Guivve-A/MyosaContest/pneumocoach/enclosure-exploded-half.png

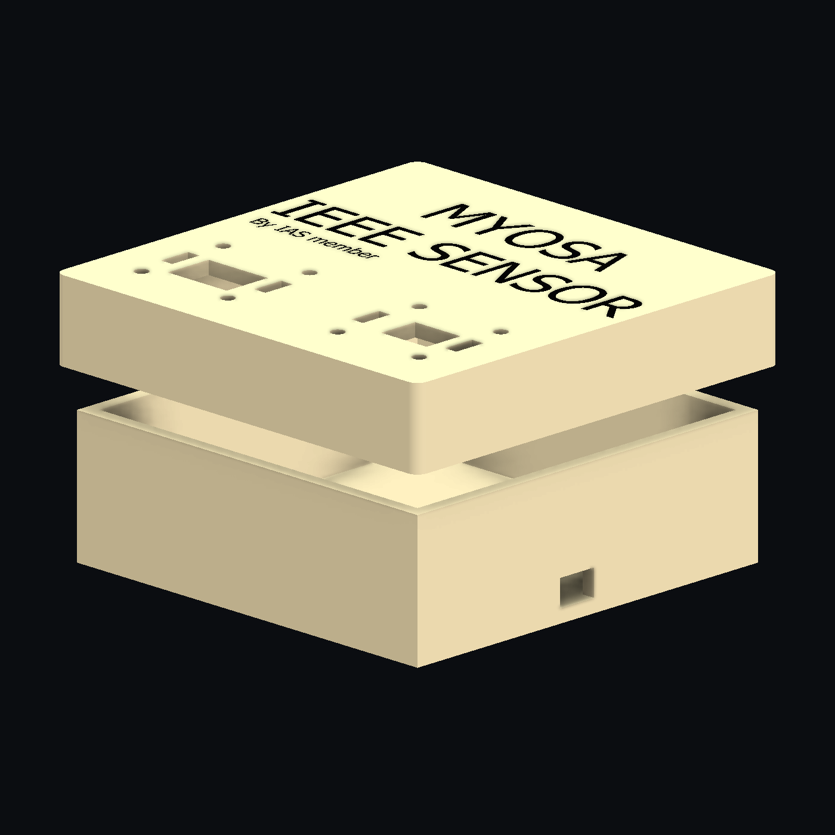
pneumocoach/enclosure-exploded-half.png
