Guivve-A/MyosaContest/pneumocoach/enclosure-lid-quarter.png

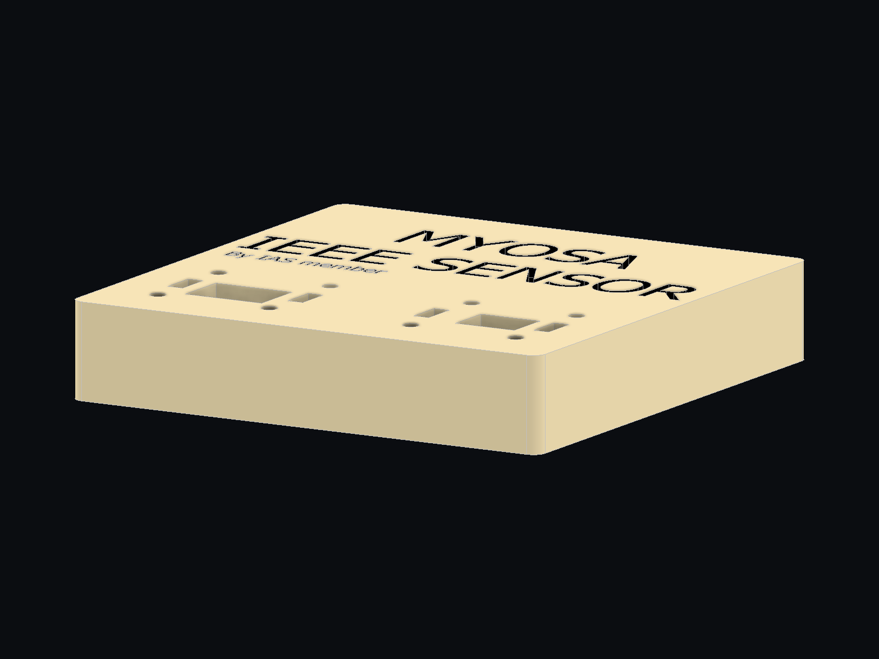
pneumocoach/enclosure-lid-quarter.png
