Guivve-A/MyosaContest/(commit log)

2026-08-25 add: full project source code (ml, firmware, tools, companion, docs/adr)
    Includes:
    - ml/: training pipeline, DSP reference, contract tests, INT8 model artifact
    - firmware/: Arduino sketch, generated C headers, factory backup
    - tools/: capture, analysis, calibration, enclosure scripts
    - companion/: Next.js BLE companion app (no node_modules)
    - docs/adr/: 11 architecture decision records
    - .gitignore: excludes node_modules, __pycache__, .next, agent files
2026-08-25 add: enclosure CAD renders (13 views), 3D showcase, and update README/submission with hardware gallery
